penoel/Pendulum_Wave/Pendulumwave.dxf

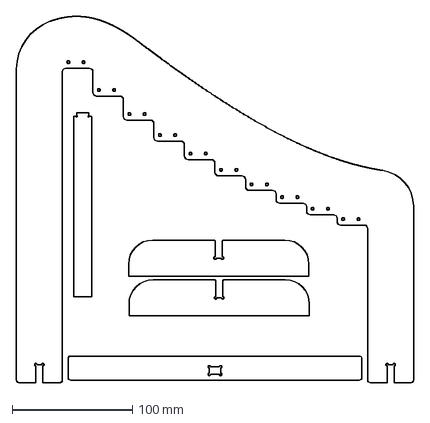
[picture p3: CAD file, 2019-07-26]
Pendulumwave.dxf
330.2 x 304.6 mm
